PNT2110/f450_esp32_mpu6500/test_xung_esc/sửa xung esc.png

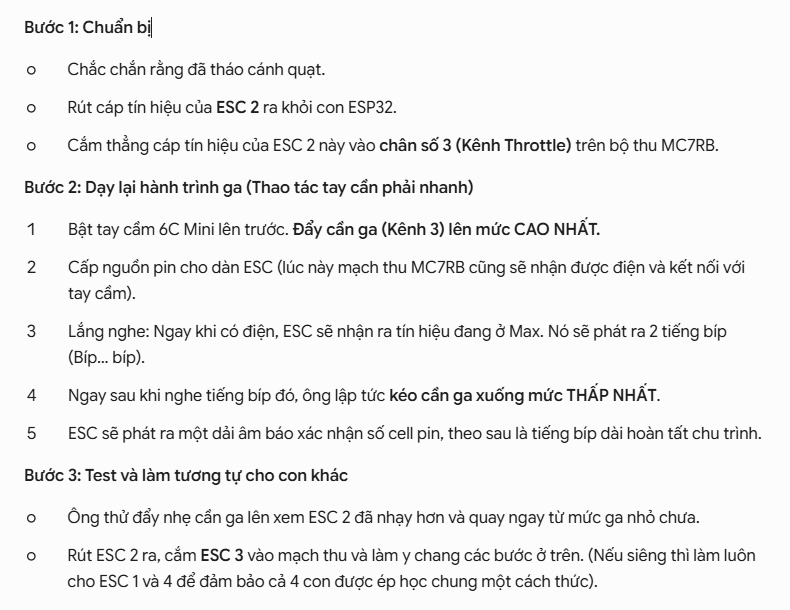
test_xung_esc/sửa xung esc.png
